GuillBla/conductivite-poudres-fil-chaud/docs/img/analyse_essai_1.png

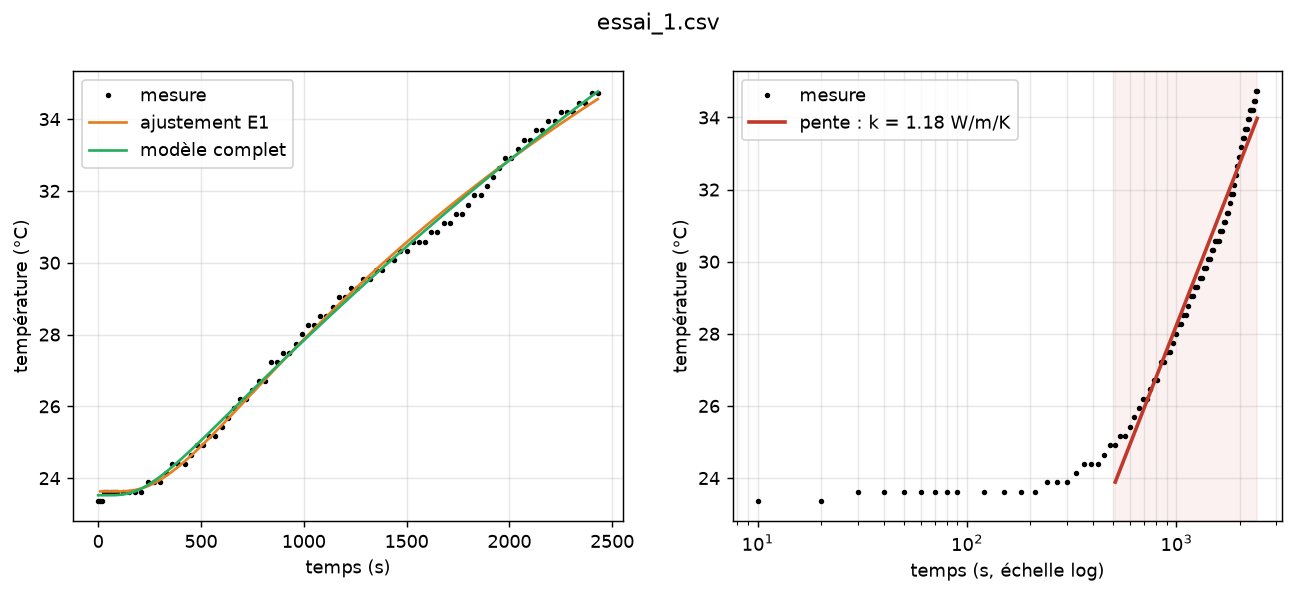
docs/img/analyse_essai_1.png
