GuillBla/conductivite-poudres-fil-chaud/docs/img/sensibilite_recommande.png

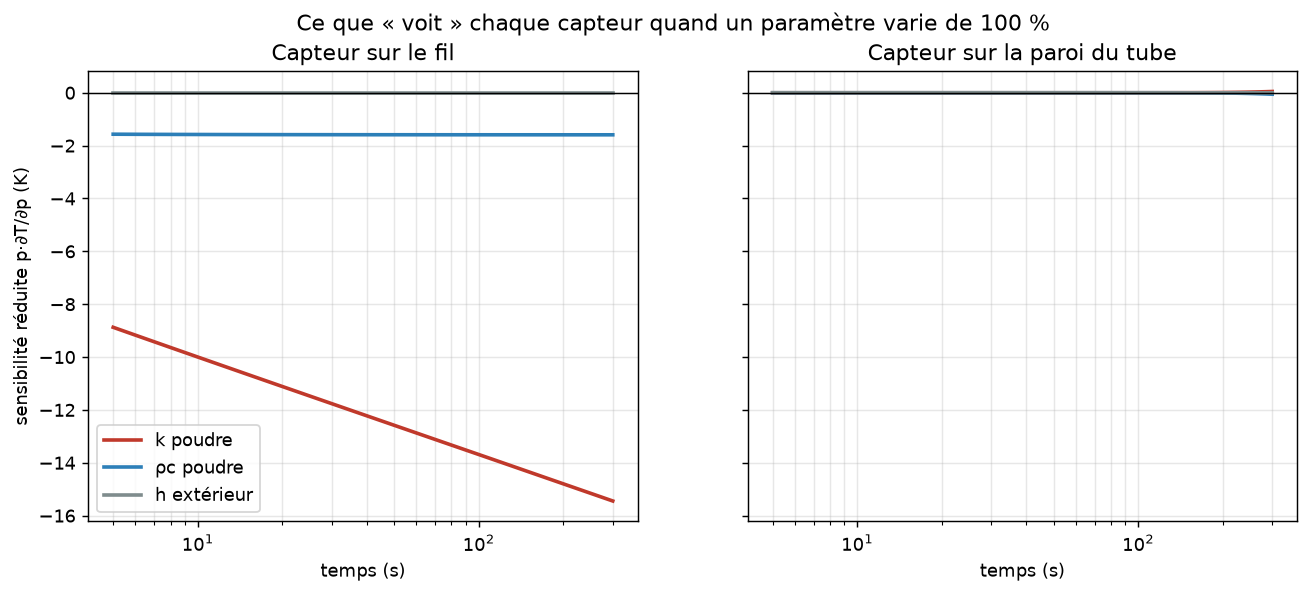
docs/img/sensibilite_recommande.png
