GuillBla/conductivite-poudres-fil-chaud/docs/img/simulation_recommande.png

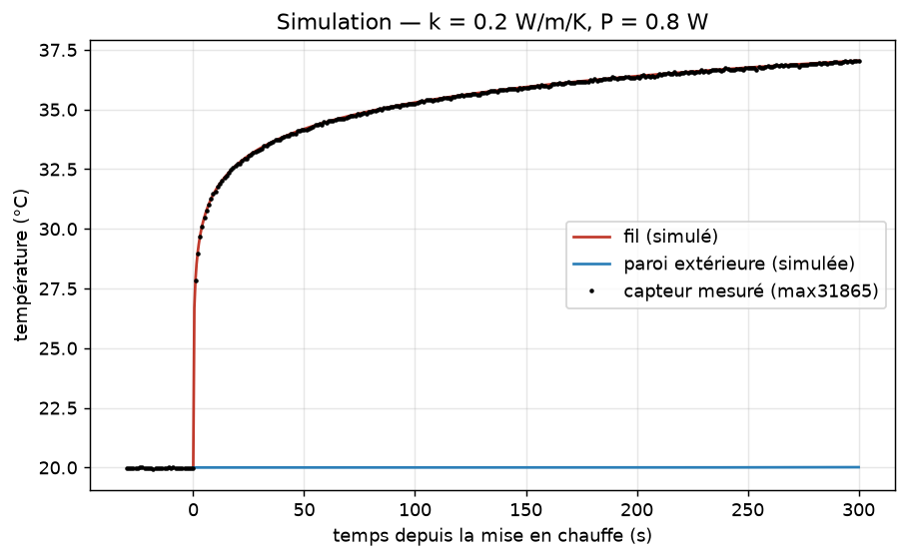
docs/img/simulation_recommande.png
