GuillBla/conductivite-poudres-fil-chaud/(commit log)

2026-11-07 v2 : documentation, simulateur, analyse et site GitHub Pages
    - Package Python hotwire : modèle thermique (solution E1 + volumes finis
    fil/poudre/tube/air), PT100 et chaînes de mesure, trois méthodes
    d'extraction de k, Arduino virtuel, acquisition série, CLI
    (simulate / analyze / acquire / design)
    - Firmware Arduino v2 : MAX31865 ou pont amélioré, pilotage de la chauffe,
    sécurités, échantillonnage sans dérive
    - Documentation : théorie, matériel, protocole, utilisation, audit de la v1
    (bug log10 du tableur, débordements de tampon, résolution de 26 °C)
    - Essais v1 extraits en CSV et réanalysés ; fichiers d'origine dans legacy/
    - Site de présentation (site/) avec simu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
    [Protech.ods, essai_1.csv, essai_2.csv, simulation_recommande.csv]
2026-11-07 Fil chauffant en Kanthal A1
    - Table des alliages de fil (Kanthal A1, nichrome, constantan) et
    dimensionnement électrique (résistance, tension, courant) dans
    `hotwire design`
    - Kanthal A1 par défaut dans les configurations (ρc = 3,27 MJ/m³/K)
    - Estimation du diamètre du fil v1 à partir de U et I (≈ Ø 0,2 mm)
    - Doc matériel et site mis à jour ; données et figures régénérées
    [simulation_recommande.csv]
2026-11-07 CI : correction du lancement des tests
    - pytest trouve le package hotwire sans installation (pythonpath)
    - test indépendant du dossier courant
    - node --test reçoit les fichiers de test, pas un dossier
2026-11-07 Fixation de la sonde sur le fil (isolation Kapton)
    - Site : section « Fixer la sonde sur le fil » (schéma, montage,
    vérifications) et règle n° 1 mise à jour
    - Doc matériel : même section, et mention de la sonde-aiguille
    - Correctif de mise en page : colonnes de texte non étirées
